jnedbal/MicroFLiC_servo_solenoid_top_1_1/MicroFLiC_servo_solenoid_top.kicad_pcb

## KiCad design MicroFLiC_servo_solenoid_top.kicad_pcb (2016-03-18)

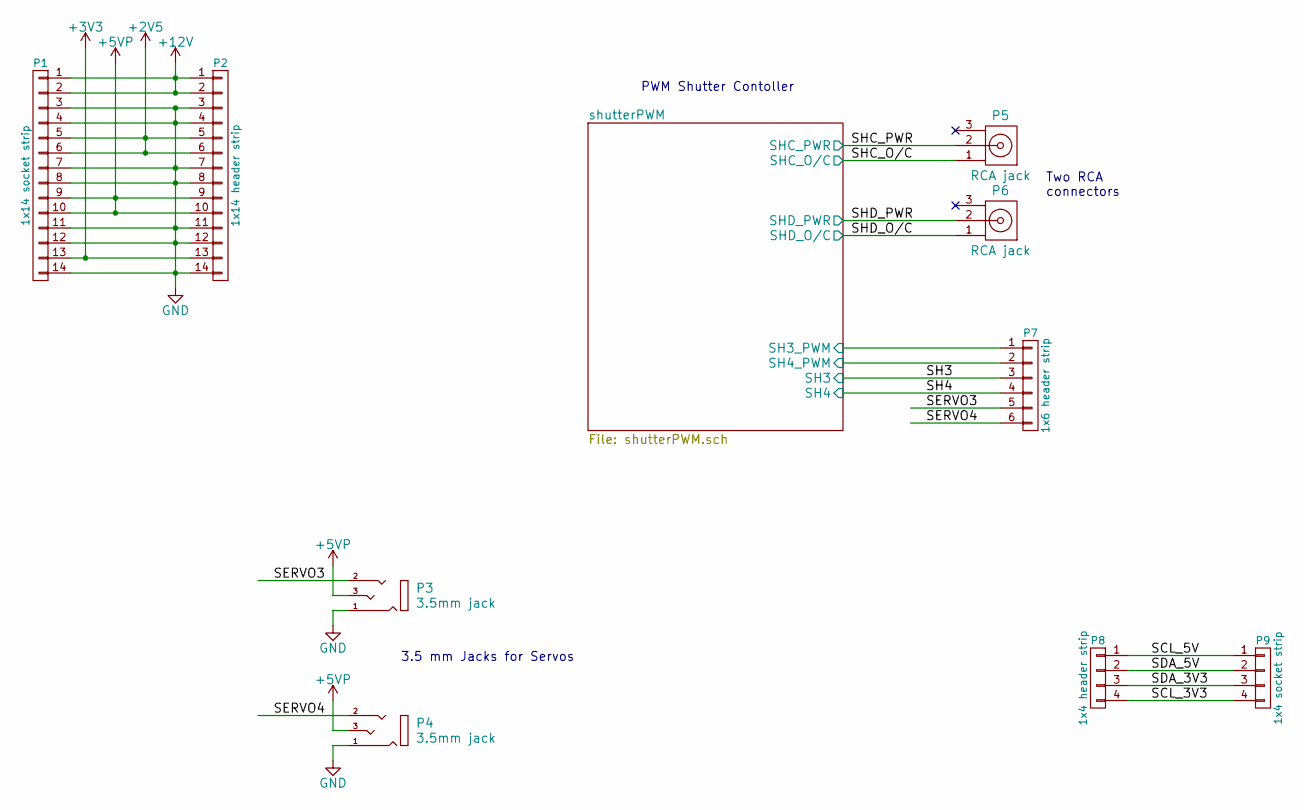
[picture p1: schematic MicroFLiC_servo_solenoid_top.sch, Flow Unit Shield]

Parts:
P1: 1x14 socket strip; ESQ-114-33-G-S; Part Number MC34735
P2: 1x14 header strip; Pin_Header_Straight_1x14; Part Number ESQ-114-33-G-S
P3, P4: 3.5mm jack; MJ4435-R; Part Number MJ4435-R
P5, P6: RCA jack; PSG01544; Part Number PSG01540
P7: 1x6 header strip; Pin_Header_Straight_1x06; Part Number ESQ-106-33-G-S
P8: 1x4 header strip; Pin_Header_Straight_1x04; Part Number M20-9990445
P9: 1x4 socket strip; ESQ-104-33-G-S; Part Number ESQ-104-33-G-S

Connections:
+2V5: P1.5, P1.6, P2.5, P2.6; also elsewhere on the board
+3V3: P1.13, P2.13
+5VP: P1.9, P1.10, P2.9, P2.10, P3.3, P4.3; also elsewhere on the board
+12V: P1.1, P1.2, P2.1, P2.2; also elsewhere on the board
/SCL_3V3: P8.4, P9.4
/SCL_5V: P8.1, P9.1
/SDA_3V3: P8.3, P9.3
/SDA_5V: P8.2, P9.2
/SERVO3: P3.2, P7.5
/SERVO4: P4.2, P7.6
/shutterPWM/SH3: P7.3; also elsewhere on the board
/shutterPWM/SH3_PWM: P7.1; also elsewhere on the board
/shutterPWM/SH4: P7.4; also elsewhere on the board
/shutterPWM/SH4_PWM: P7.2; also elsewhere on the board
/shutterPWM/SHC_O/C: P5.1; also elsewhere on the board
/shutterPWM/SHC_PWR: P5.2; also elsewhere on the board
/shutterPWM/SHD_O/C: P6.1; also elsewhere on the board
/shutterPWM/SHD_PWR: P6.2; also elsewhere on the board
GND: P1.3, P1.4, P1.7, P1.8, P1.11, P1.12, P1.14, P2.3, P2.4, P2.7, P2.8, P2.11, P2.12, P2.14, P3.1, P4.1; also elsewhere on the board

Notes on the sheet:
Two RCA connectors
PWM Shutter Contoller
3.5 mm Jacks for Servos

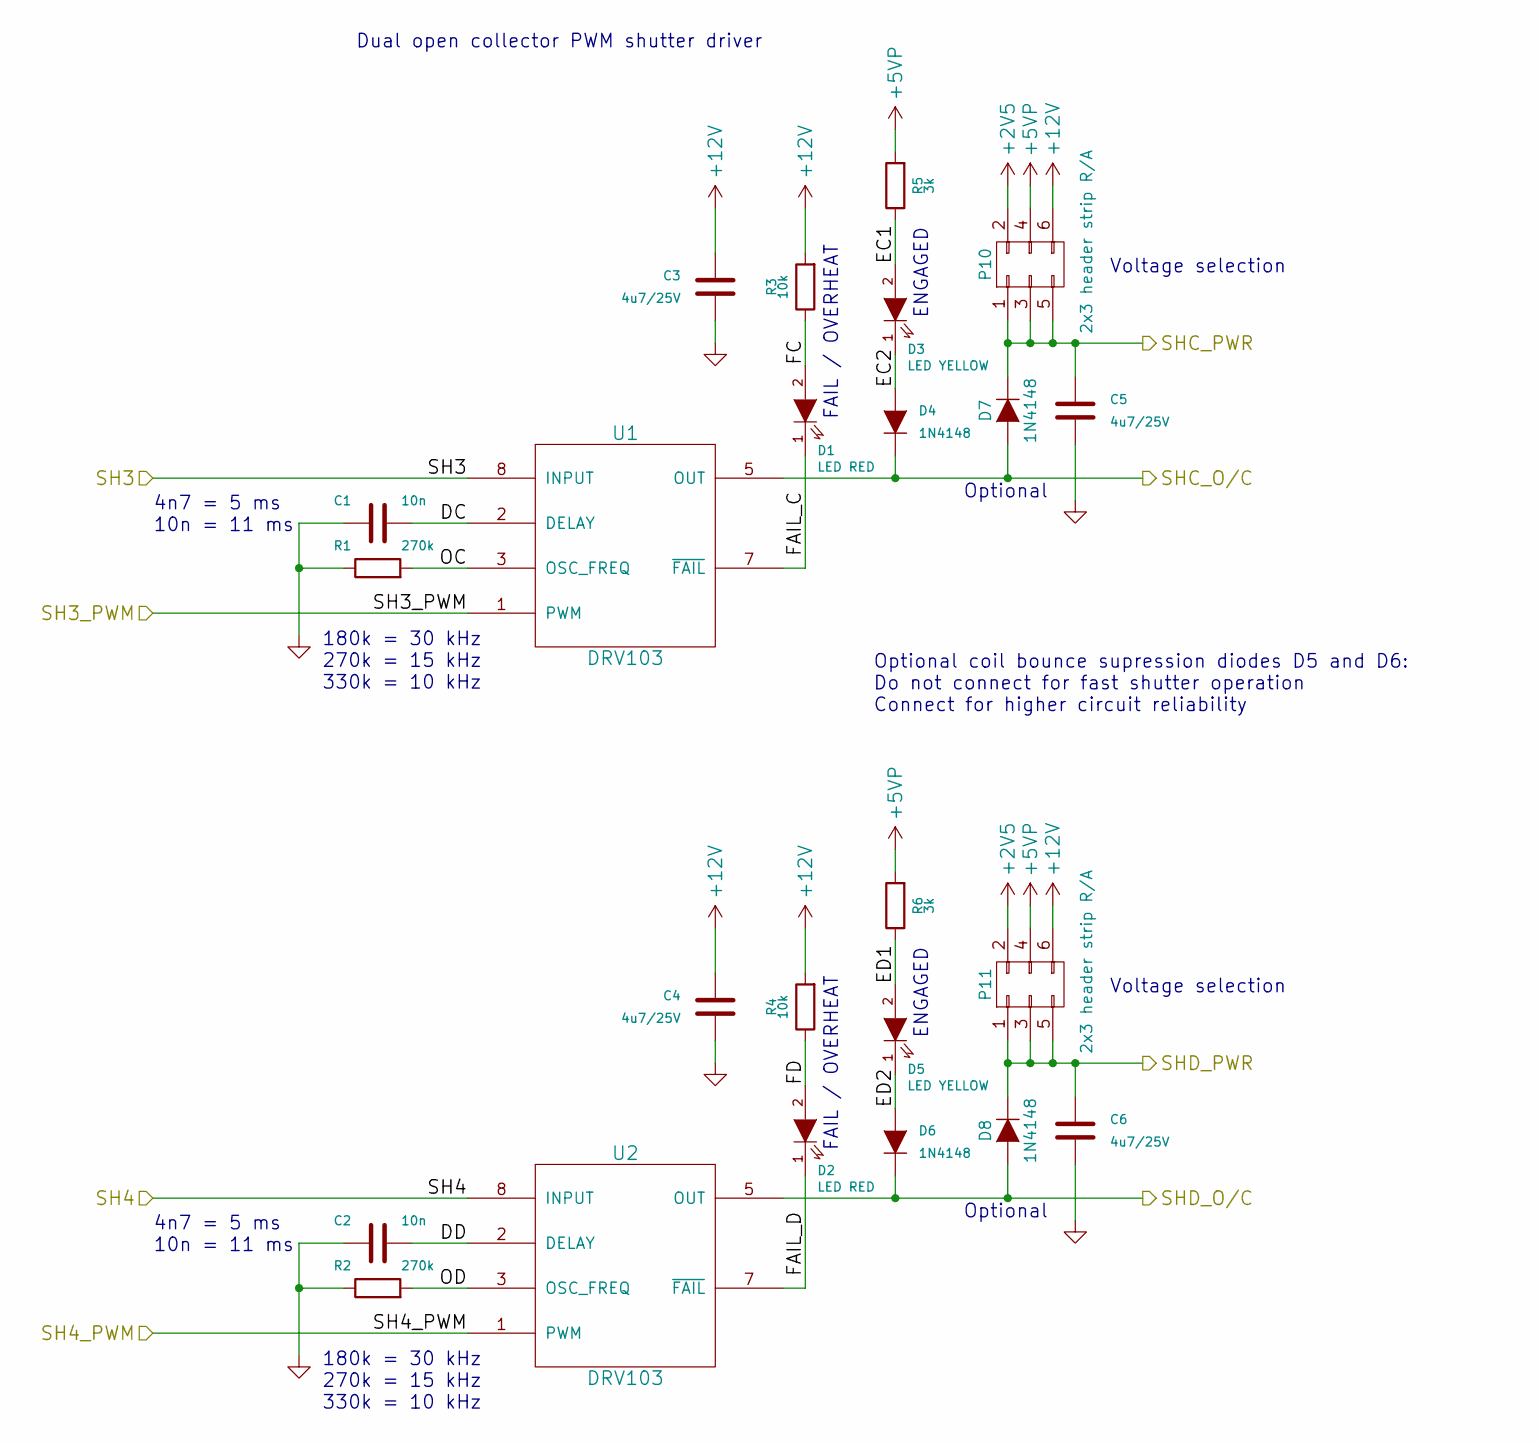
[picture p2: schematic shutterPWM.sch, Flow Unit Shield]

Parts:
C1, C2: 10n; C_0805; Part Number MCU0805R103KCT
C3, C4, C5, C6: 4u7/25V; C_0805; Part Number GRM21BR61E475MA12L
D1, D2: LED RED; LED-1206; Part Number HSMS-C150
D3, D5: LED YELLOW; LED-1206; Part Number HSMY-C150
D4, D6, D7, D8: 1N4148; SOD-323; Part Number 1N4148WS
P10, P11: 2x3 header strip R/A; Pin_Header_Angled_2x03; Part Number 2213R-06G
R1, R2: 270k; R_0805; Part Number MCSR08X2703FTL
R3, R4: 10k; R_0805; Part Number MCMR08X1002FTL
R5, R6: 3k; R_0805; Part Number MC01W080513K
U1, U2: DRV103; SOIC-8_3.9x4.9mm_Pitch1.27mm; Part Number DRV103UG4

Connections:
+2V5: P10.2, P11.2; also elsewhere on the board
+5VP: P10.4, P11.4, R5.2, R6.2; also elsewhere on the board
+12V: C3.2, C4.2, P10.6, P11.6, R3.2, R4.2, U1.6 (+12V), U2.6 (+12V); also elsewhere on the board
/shutterPWM/DC: C1.2, U1.2 (DELAY)
/shutterPWM/DD: C2.2, U2.2 (DELAY)
/shutterPWM/EC1: D3.2 (A), R5.1
/shutterPWM/EC2: D3.1 (K), D4.2 (A)
/shutterPWM/ED1: D5.2 (A), R6.1
/shutterPWM/ED2: D5.1 (K), D6.2 (A)
/shutterPWM/FAIL_C: D1.1 (K), U1.7 (~FAIL)
/shutterPWM/FAIL_D: D2.1 (K), U2.7 (~FAIL)
/shutterPWM/FC: D1.2 (A), R3.1
/shutterPWM/FD: D2.2 (A), R4.1
/shutterPWM/OC: R1.2, U1.3 (OSC_FREQ)
/shutterPWM/OD: R2.2, U2.3 (OSC_FREQ)
/shutterPWM/SH3: U1.8 (INPUT); also elsewhere on the board
/shutterPWM/SH3_PWM: U1.1 (PWM); also elsewhere on the board
/shutterPWM/SH4: U2.8 (INPUT); also elsewhere on the board
/shutterPWM/SH4_PWM: U2.1 (PWM); also elsewhere on the board
/shutterPWM/SHC_O/C: D4.1 (K), D7.2 (A), U1.5 (OUT); also elsewhere on the board
/shutterPWM/SHC_PWR: C5.2, D7.1 (K), P10.1, P10.3, P10.5; also elsewhere on the board
/shutterPWM/SHD_O/C: D6.1 (K), D8.2 (A), U2.5 (OUT); also elsewhere on the board
/shutterPWM/SHD_PWR: C6.2, D8.1 (K), P11.1, P11.3, P11.5; also elsewhere on the board
GND: C1.1, C2.1, C3.1, C4.1, C5.1, C6.1, R1.1, R2.1, U1.4 (GND), U2.4 (GND); also elsewhere on the board

Notes on the sheet:
Dual open collector PWM shutter driver
Optional coil bounce supression diodes D5 and D6: Do not connect for fast shutter operation Connect for higher circuit reliability
180k = 30 kHz 270k = 15 kHz 330k = 10 kHz
4n7 = 5 ms 10n = 11 ms
FAIL / OVERHEAT
ENGAGED
Voltage selection
Optional

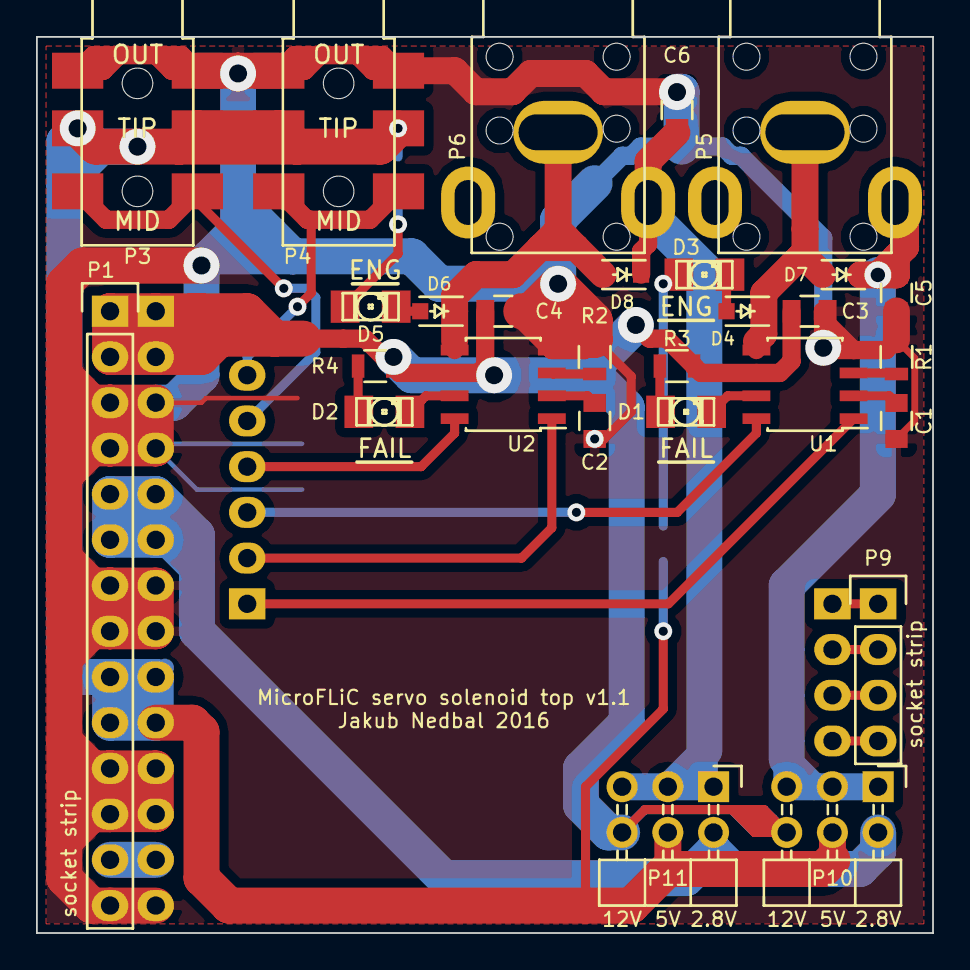
[picture p3: board MicroFLiC_servo_solenoid_top.kicad_pcb from above]

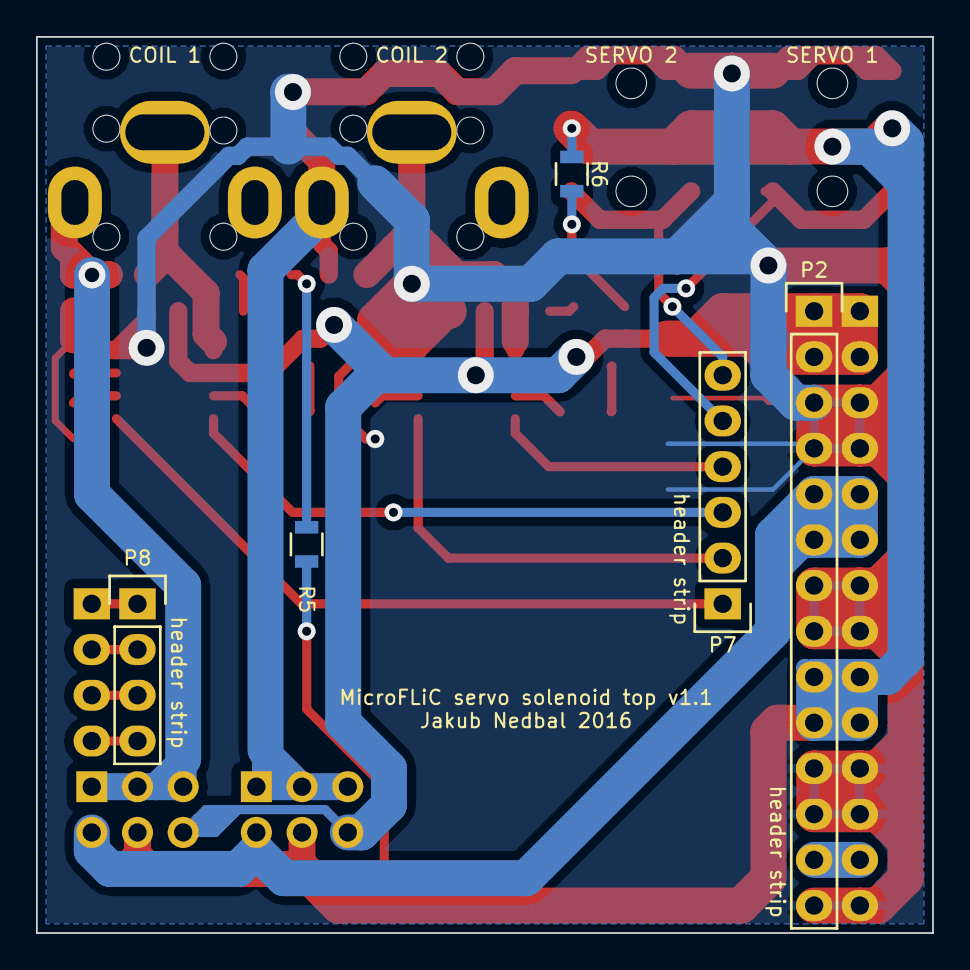
[picture p4: board MicroFLiC_servo_solenoid_top.kicad_pcb from below]

Board: 2 copper layers, 49.8 x 49.8 mm, 33 parts (5 on the bottom side), 31 nets.
