jnedbal/MicroFLiC_servo_solenoid_top_1_1/MicroFLiC_servo_solenoid_bottom.kicad_pcb

## KiCad design MicroFLiC_servo_solenoid_bottom.kicad_pcb (2016-02-29)

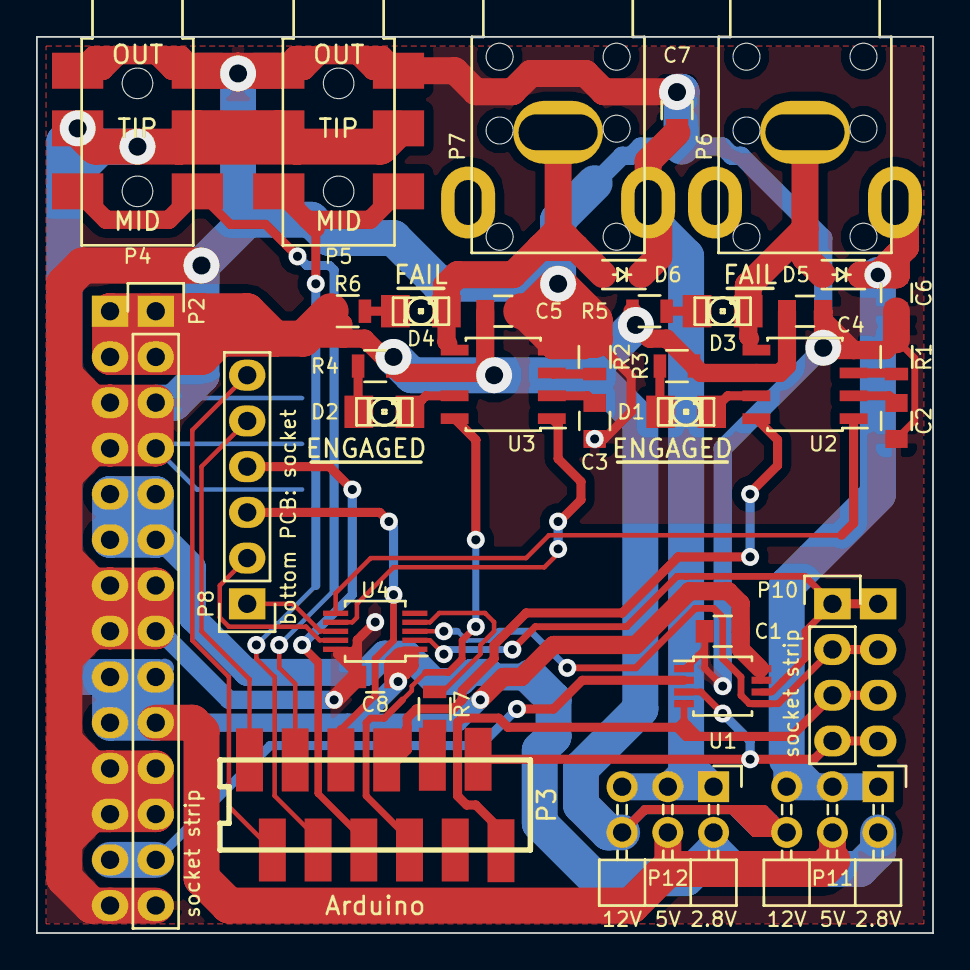
[picture p5: board MicroFLiC_servo_solenoid_bottom.kicad_pcb from above]

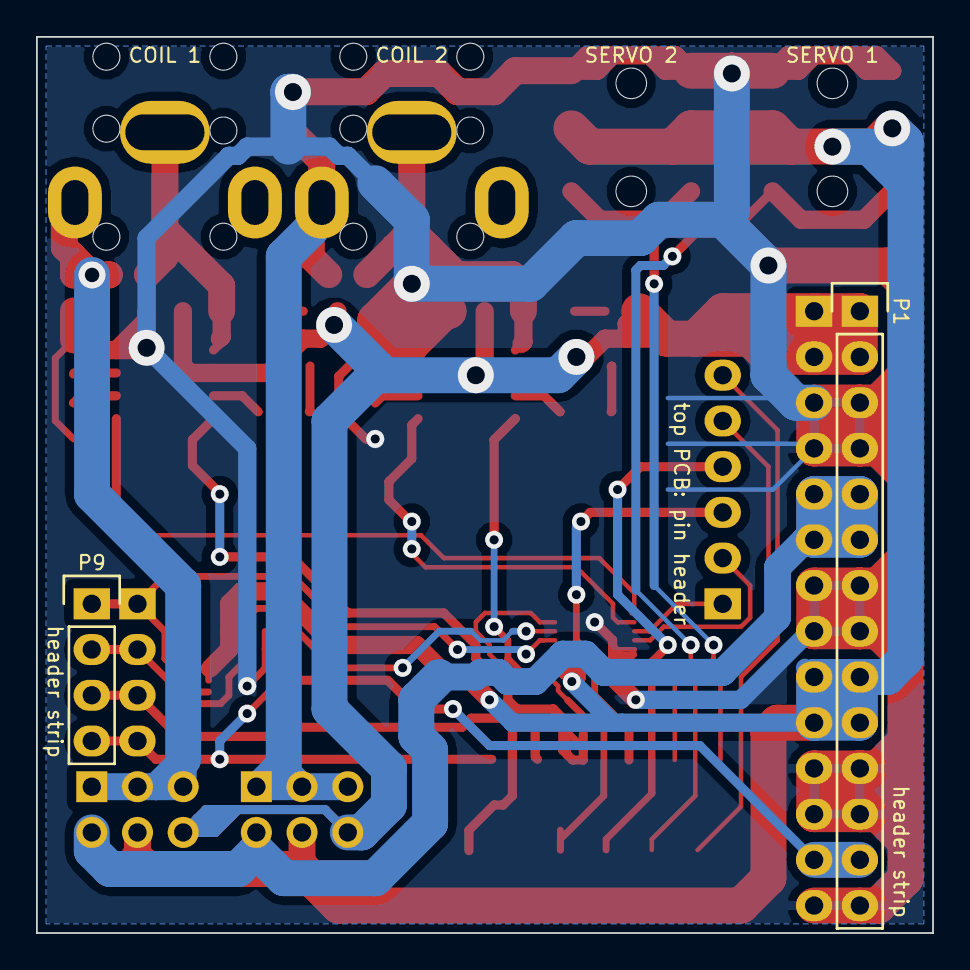
[picture p6: board MicroFLiC_servo_solenoid_bottom.kicad_pcb from below]

Board: 2 copper layers, 49.8 x 49.8 mm, 37 parts (2 on the bottom side), 37 nets.

Parts:
C1, C8: 100n; C_0805
C2, C3: 10n; C_0805
C4, C5, C6, C7: 4u7/25V; C_0805
D1, D2: LED RED; LED-1206
D3, D4: LED YELLOW; LED-1206
D5, D6: 1N4148; SOD-323
P1: 1x14 header strip; Pin_Header_Straight_1x14
P2: 1x14 socket strip; ESQ-114-33-G-S
P3: 12-way Micro-MaTch; 1-188275-2
P4, P5: Jack_3.5mm_3pin; MJ4435-R
P6, P7: RCA_3; PSG01544
P8: 1x6 socket strip; ESQ-106-33-G-S
P9: 1x4 header strip; Pin_Header_Straight_1x04
P10: 1x4 socket strip; ESQ-104-33-G-S
P11, P12: 2x3 header strip R/A; Pin_Header_Angled_2x03
R1, R2: 270k; R_0805
R3, R4, R5, R6: 10k; R_0805
R7: 0R; R_0805
U1: PCA9306DP; TSSOP-8_3x3mm_Pitch0.65mm
U2, U3: DRV103; SOIC-8_3.9x4.9mm_Pitch1.27mm
U4: MCP4728; MSOP-10_3x3mm_Pitch0.5mm

Connections:
+2V5: P1.5, P1.6, P2.5, P2.6, P11.2, P12.2
+3V3: P1.13, P2.13, U1.2
+5VP: C1.1, C8.2, P1.9, P1.10, P2.9, P2.10, P4.3, P5.3, P11.4, P12.4, U1.7, U1.8, U4.1
+12V: C4.2, C5.2, P1.1, P1.2, P2.1, P2.2, P11.6, P12.6, R3.2, R4.2, R5.2, R6.2, U2.6, U3.6
/I2C/SCL_3V3: P3.11, P9.4, P10.4, U1.3
/I2C/SCL_5V: P9.1, P10.1, U1.6, U4.2
/I2C/SDA_3V3: P3.12, P9.3, P10.3, U1.4
/I2C/SDA_5V: P9.2, P10.2, U1.5, U4.3
/SERVO1: P3.3, P4.2
/SERVO2: P3.4, P5.2
/SERVO3: P3.1, P8.5
/SERVO4: P3.2, P8.6
/SH3: P3.5, P8.3
/SH4: P3.6, P8.4
/shutterPWM/DA: C2.2, U2.2
/shutterPWM/DB: C3.2, U3.2
/shutterPWM/EA: D1.2, R3.1
/shutterPWM/EB: D2.2, R4.1
/shutterPWM/ENG_A: D1.1, U2.7
/shutterPWM/ENG_B: D2.1, U3.7
/shutterPWM/FA: D3.2, R5.1
/shutterPWM/FB: D4.2, R6.1
/shutterPWM/OA: R1.2, U2.3
/shutterPWM/OB: R2.2, U3.3
/shutterPWM/SH1: P3.7, U2.8
/shutterPWM/SH1_PWM: U2.1, U4.6
/shutterPWM/SH2: P3.8, U3.8
/shutterPWM/SH2_PWM: U3.1, U4.7
/shutterPWM/SH3_PWM: P8.1, U4.8
/shutterPWM/SH4_PWM: P8.2, U4.9
/shutterPWM/SHA_O/C: D3.1, D5.2, P6.1, U2.5
/shutterPWM/SHA_PWR: C6.2, D5.1, P6.2, P11.1, P11.3, P11.5
/shutterPWM/SHB_O/C: D4.1, D6.2, P7.1, U3.5
/shutterPWM/SHB_PWR: C7.2, D6.1, P7.2, P12.1, P12.3, P12.5
/shutterPWM/SH_~LDAC: P3.9, R7.1
GND: C1.2, C2.1, C3.1, C4.1, C5.1, C6.1, C7.1, C8.1, P1.3, P1.4, P1.7, P1.8, P1.11, P1.12, P1.14, P2.3, P2.4, P2.7, P2.8, P2.11, P2.12, P2.14, P4.1, P5.1, R1.1, R2.1, U1.1, U2.4, U3.4, U4.10
unnamed: R7.2, U4.4
