jnedbal/MicroFLiC_servo_solenoid_top_1_1/(commit log)

2016-01-06 Final production board v1.0
    [I2C_1_0.sch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]
2016-02-19 Added component descriptions
    [MicroFLiC_servo_solenoid_1_0.csv, MicroFLiC_servo_solenoid_1_0.sch, shutterPWM_1_0.sch]
2016-02-28 Renamed solenoid to v1.1, added part descriptions
    [I2C.sch, MicroFLiC_servo_solenoid_1_0.csv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]
2016-02-29 Deleted redundant resistors and labels from PCB
    [MicroFLiC_servo_solenoid_bottom.kicad_pcb]
2016-02-29 Fixed PCB routing
    [I2C.sch, MicroFLiC_servo_solenoid_bottom.kicad_pcb, MicroFLiC_servo_solenoid_bottom.sch, shutterPWM.sch]
2016-02-29 Created v1.1, got rid of all redundant parts for separate top and bottom boards
    [MicroFLiC_servo_solenoid_bottom.csv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]
2016-02-29 Removed I2C.sch
    [I2C.sch]
2016-03-02 Added better de-bouncing diode description
    [MicroFLiC_servo_solenoid_top.csv, MicroFLiC_servo_solenoid_top.kicad_pcb, MicroFLiC_servo_solenoid_top.sch, shutterPWM.sch]
2016-03-18 Changed ENGAGED LED anode to +5V, changed SOD-323 packages, tidied up layout
    [MicroFLiC_servo_solenoid_top.csv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]
